practable/refrigeration/documentation/Gunt ET411C Refrigeration experiment conversion parts list.xlsx

Sheet: Mechanical parts
Part required | Manufacturer | Mfr P.N. | Price | Supplier | Qty Rq'd |  | Total | Delivery time | Link
solenoid valve body | Danfoss | 032f8107 | £30.68 | Dean&Wood | 8 |  | £245.44 | 1-2 days | https://www.dean-wood.co.uk/all-products/mechanical-controls/solenoid-valves-coils/danfoss-solenoid-valves/032f805600/danfoss-solenoid-valves-evr-flare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
solenoid valve coil | Danfoss | 018F6857 | £48.63 | Dean&Wood | 8 |  | £389.04 | 1-2 days | https://www.dean-wood.co.uk/all-products/mechanical-controls/solenoid-valves-coils/danfoss-solenoid-coils/018f685600/danfoss-solenoid-coils-12-24v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
30bar pressure sensor | Alco | PT3 30V 802 281 |  | Radwood | 1 |  | £185.17 | 9-11 weeks | https://www.radward.co.uk/alco/pt3-30v-802281 | https://apjeuropean.co.uk/contact/
 |  |  |  | Dean&Wood |  |  | £272.22 | 4-6weeks | USE THIS ONE - DUE TO LEAD TIME
18L flow meter | ABB | FAM3255 |  | JWF Ltd | 1 |  | £1623.11 | 8-9 weeks | https://library.e.abb.com/public/8e1f9d214ac8421ca3b166d2a52b90ee/DS_FAM3200_EN_G.pdf
Degas-regas (2 visits) | Swan Refrigeration |  | £300.00 |  | 1 |  | £300.00 |  | 0131 448 0880 ask for George
Terminals/wires etc | misc |  | £150.00 |  | 1 |  | £150.00
 |  |  |  |  |  |  | Grand total
 |  |  |  |  |  |  | £2979.81
 |  |  |  |  |  | Plus 20% | £3575.77

Sheet: Electronic parts
 |  |  |  |  | V |  |  |  |  |  | W | W | A
 | Equipment |  | Quantity |  | Vin | Signal | Link |  | Cost€ | Cost (£) | Power (single) | Power Total | I @ 24v
Digital Outputs
 |  |  |  |  |  |  | ADAM-5069
 | Valve Relay |  | 8 |  | 24v coil | n/a | https://buy.advantech.eu/I-O-Devices-Communication/Remote-I-O-Modules-ADAM-I-O-Modules/model-ADAM-5069-AE.htm |  | €128.64 |  | 16 | 128 | 5.33
 |  |  |  |  |  |  | 8 ch relay output module
Analog Inputs
 | Pressure Sensors (1-6V) |  | 3 |  | 10-28 | 1-6v | ADAM-5017 |  |  |  | 5 | 15 | 0.62
 |  |  |  |  |  |  | https://buy.advantech.eu/I-O-Devices-Communication/Remote-I-O-Modules-ADAM-I-O-Modules/model-ADAM-5017-A4E.htm |  | €236.54
 | Temperature Sensor (TC) |  | 5 |  | already in system | 0-10 (max) | mV, V, mA input |  |  |  | 5 | 25 | 1.04
 |  |  |  |  |  |  | 8 channel differential
 |  | Total | 8
 |  |  |  |  |  |  | ADAM-5017
 | Flow Meter (4-20mA) |  | 1 |  | 10-28 |  | https://buy.advantech.eu/I-O-Devices-Communication/Remote-I-O-Modules-ADAM-I-O-Modules/model-ADAM-5017-A4E.htm |  | €236.54 |  | 5 | 5 | 0.21
 |  |  |  |  |  |  | mV, V, mA input
 |  |  |  |  |  |  | 8 channel differential
DAQ Chassis
 |  |  |  |  |  |  | ADAM-5000 DAQ Chassis
 | ADAM 4 Slot Ethernet |  | 1 |  | 24v |  | https://buy.advantech.eu/I-O-Devices-Communication/Remote-I-O-Modules-ADAM-Controllers/model-ADAM-5000L/TCP-BE.htm |  | €398.00 |  | 5 | 5 | 0.21
 |  |  |  |  |  |  | https://www.impulse-embedded.co.uk/products/adam_5000l~tcp--Distributed-DAQ-system.htm | alt supplier
Power Supply
 |  |  |  |  |  |  | Weidmuller 24v PSU
 | 24v PSU |  | 1 |  | 240v | 24v | https://uk.rs-online.com/web/p/din-rail-power-supplies/9236504 |  |  | £131.96
Sundrie Electronics Parts (terminals etc) |  |  |  |  |  |  |  |  |  | £200.00
 |  |  |  |  |  |  | Total |  | €999.72 | £331.96 |  | 178 | 7.4
 |  |  |  |  |  |  |  |  | £854.46
 |  |  |  |  |  |  |  | Total Total |  | £1186.42
 |  |  |  | £ | €0.00
 |  |  | Exchange Rate | £1.00 | £1.17 |  |  | plus 20% |  | £1423.71
 |  |  |  | £0.85 | €1.00
