practable/refrigeration/documentation/2. Experiment data 202310.19-2023.10.20.xlsx

Refrigeration experiment Date (2023.10.19-2023.10-20)
 | Ts(min) | T1(°C) | T2(°C) | T3 (°C) | T4(°C) | T5(°C) | p1(bar) | p2(bar) | p3(bar) | F(L/h) | E(W)
Initial (2023.10.19) | 0 | 26.5 | 26.5 | 26.8 | 27.5 | 27.1 | 6 | 6 | 6 | 0 | 0
Expansion Valve(half open) | 30 | 6.7 | 56 | 44.8 | 7.2 | 6.4 | 2.62 | 11.48 | 11.52 | 7.5 | 203.2 | 204.7 | 202.6
Interval for next experiment | 33 | 28.2 | 29.2 | 26.5 | 21.9 | 23.8 | 5 | 7 | 7 | 0 | 0
Capillary X1(half open) | 33 | 13.9 | 82.5 | 38.8 | 5.6 | 5.3 | 2.58 | 12.5 | 12.54 | 6 | 200.2 | 201.5 | 199.9
Initial(2023.10.20) | 0 | 23.6 | 23.6 | 24 | 24 | 24.5 | 5.5 | 5.5 | 5.5 | 0 | 0
Capillary X2 | 31 | 5.4 | 69.5 | 43.4 | 5.4 | 4.9 | 2.45 | 11.49 | 11.52 | 6.9 | 198.4 | 199.7 | 197.5
Interval for next experiment | 30 | 25.6 | 30 | 25.4 | 24 | 25 | 5.3 | 6.8 | 6.8 | 0 | 0
Capillary X3 | 30 | 13.7 | 85.9 | 35.3 | 5.6 | 4.9 | 2.42 | 14.3 | 14.3 | 6.2 | 207.4 | 206.9 | 208.3
Interval for next experiment | 60 | 30.7 | 31.4 | 26.9 | 26.4 | 26.4 | 5.8 | 6.6 | 6.7 | 0 | 0
Expansion Valve(fully open) | 33 | 7 | 68.6 | 46.4 | 7.5 | 6.9 | 2.65 | 11.1 | 11.3 | 7.5 | 208.3 | 209.1 | 208.6
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
