practable/refrigeration/documentation/refrigeration-experiment-P&ID.jpg

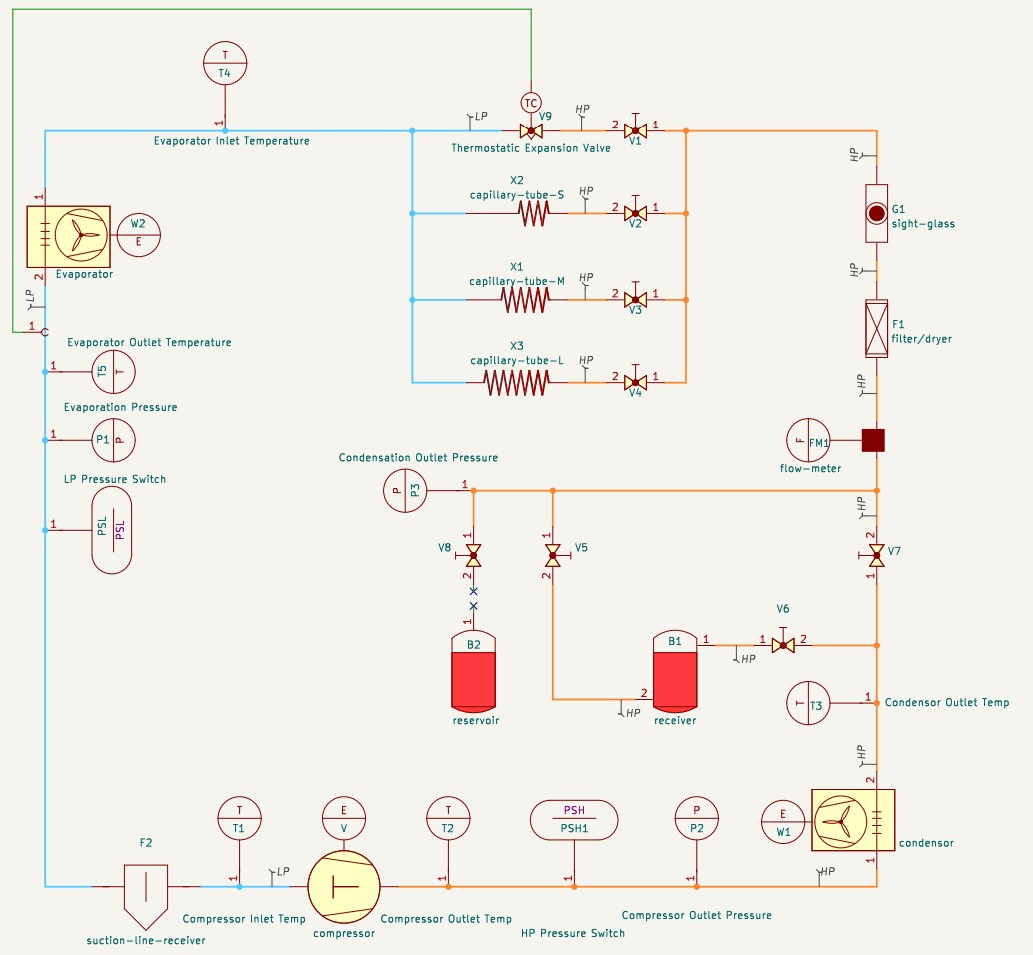
documentation/refrigeration-experiment-P&ID.jpg
