practable/refrigeration/documentation/BME280_breakout_schematic.pdf

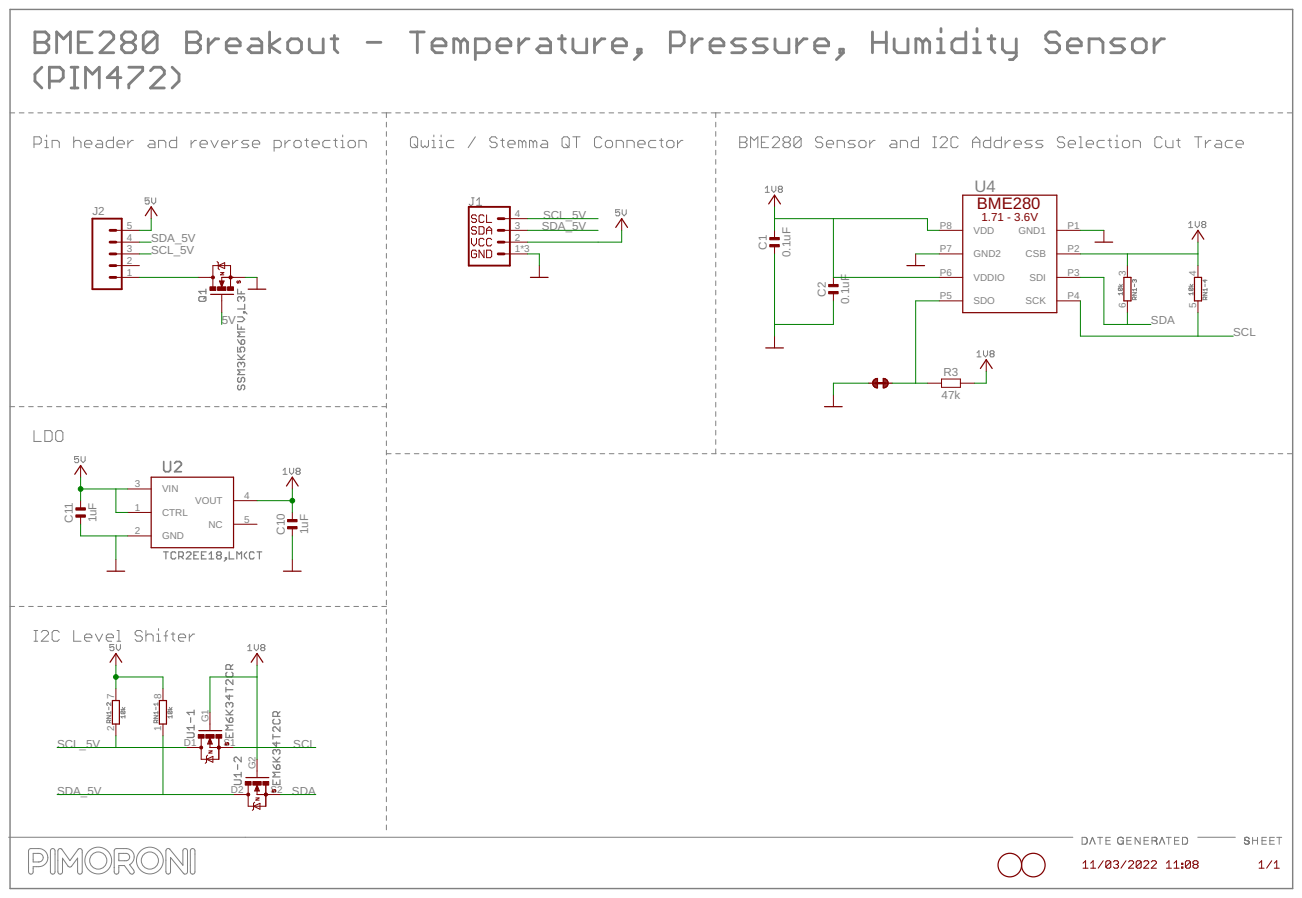
[picture p5: page 1]
