practable/refrigeration/refridgeration-rig-P&ID/refridgeration-rig-P&ID.kicad_sch

## KiCad design refridgeration-rig-P&ID/refridgeration-rig-P&ID.kicad_sch (2024-02-01)

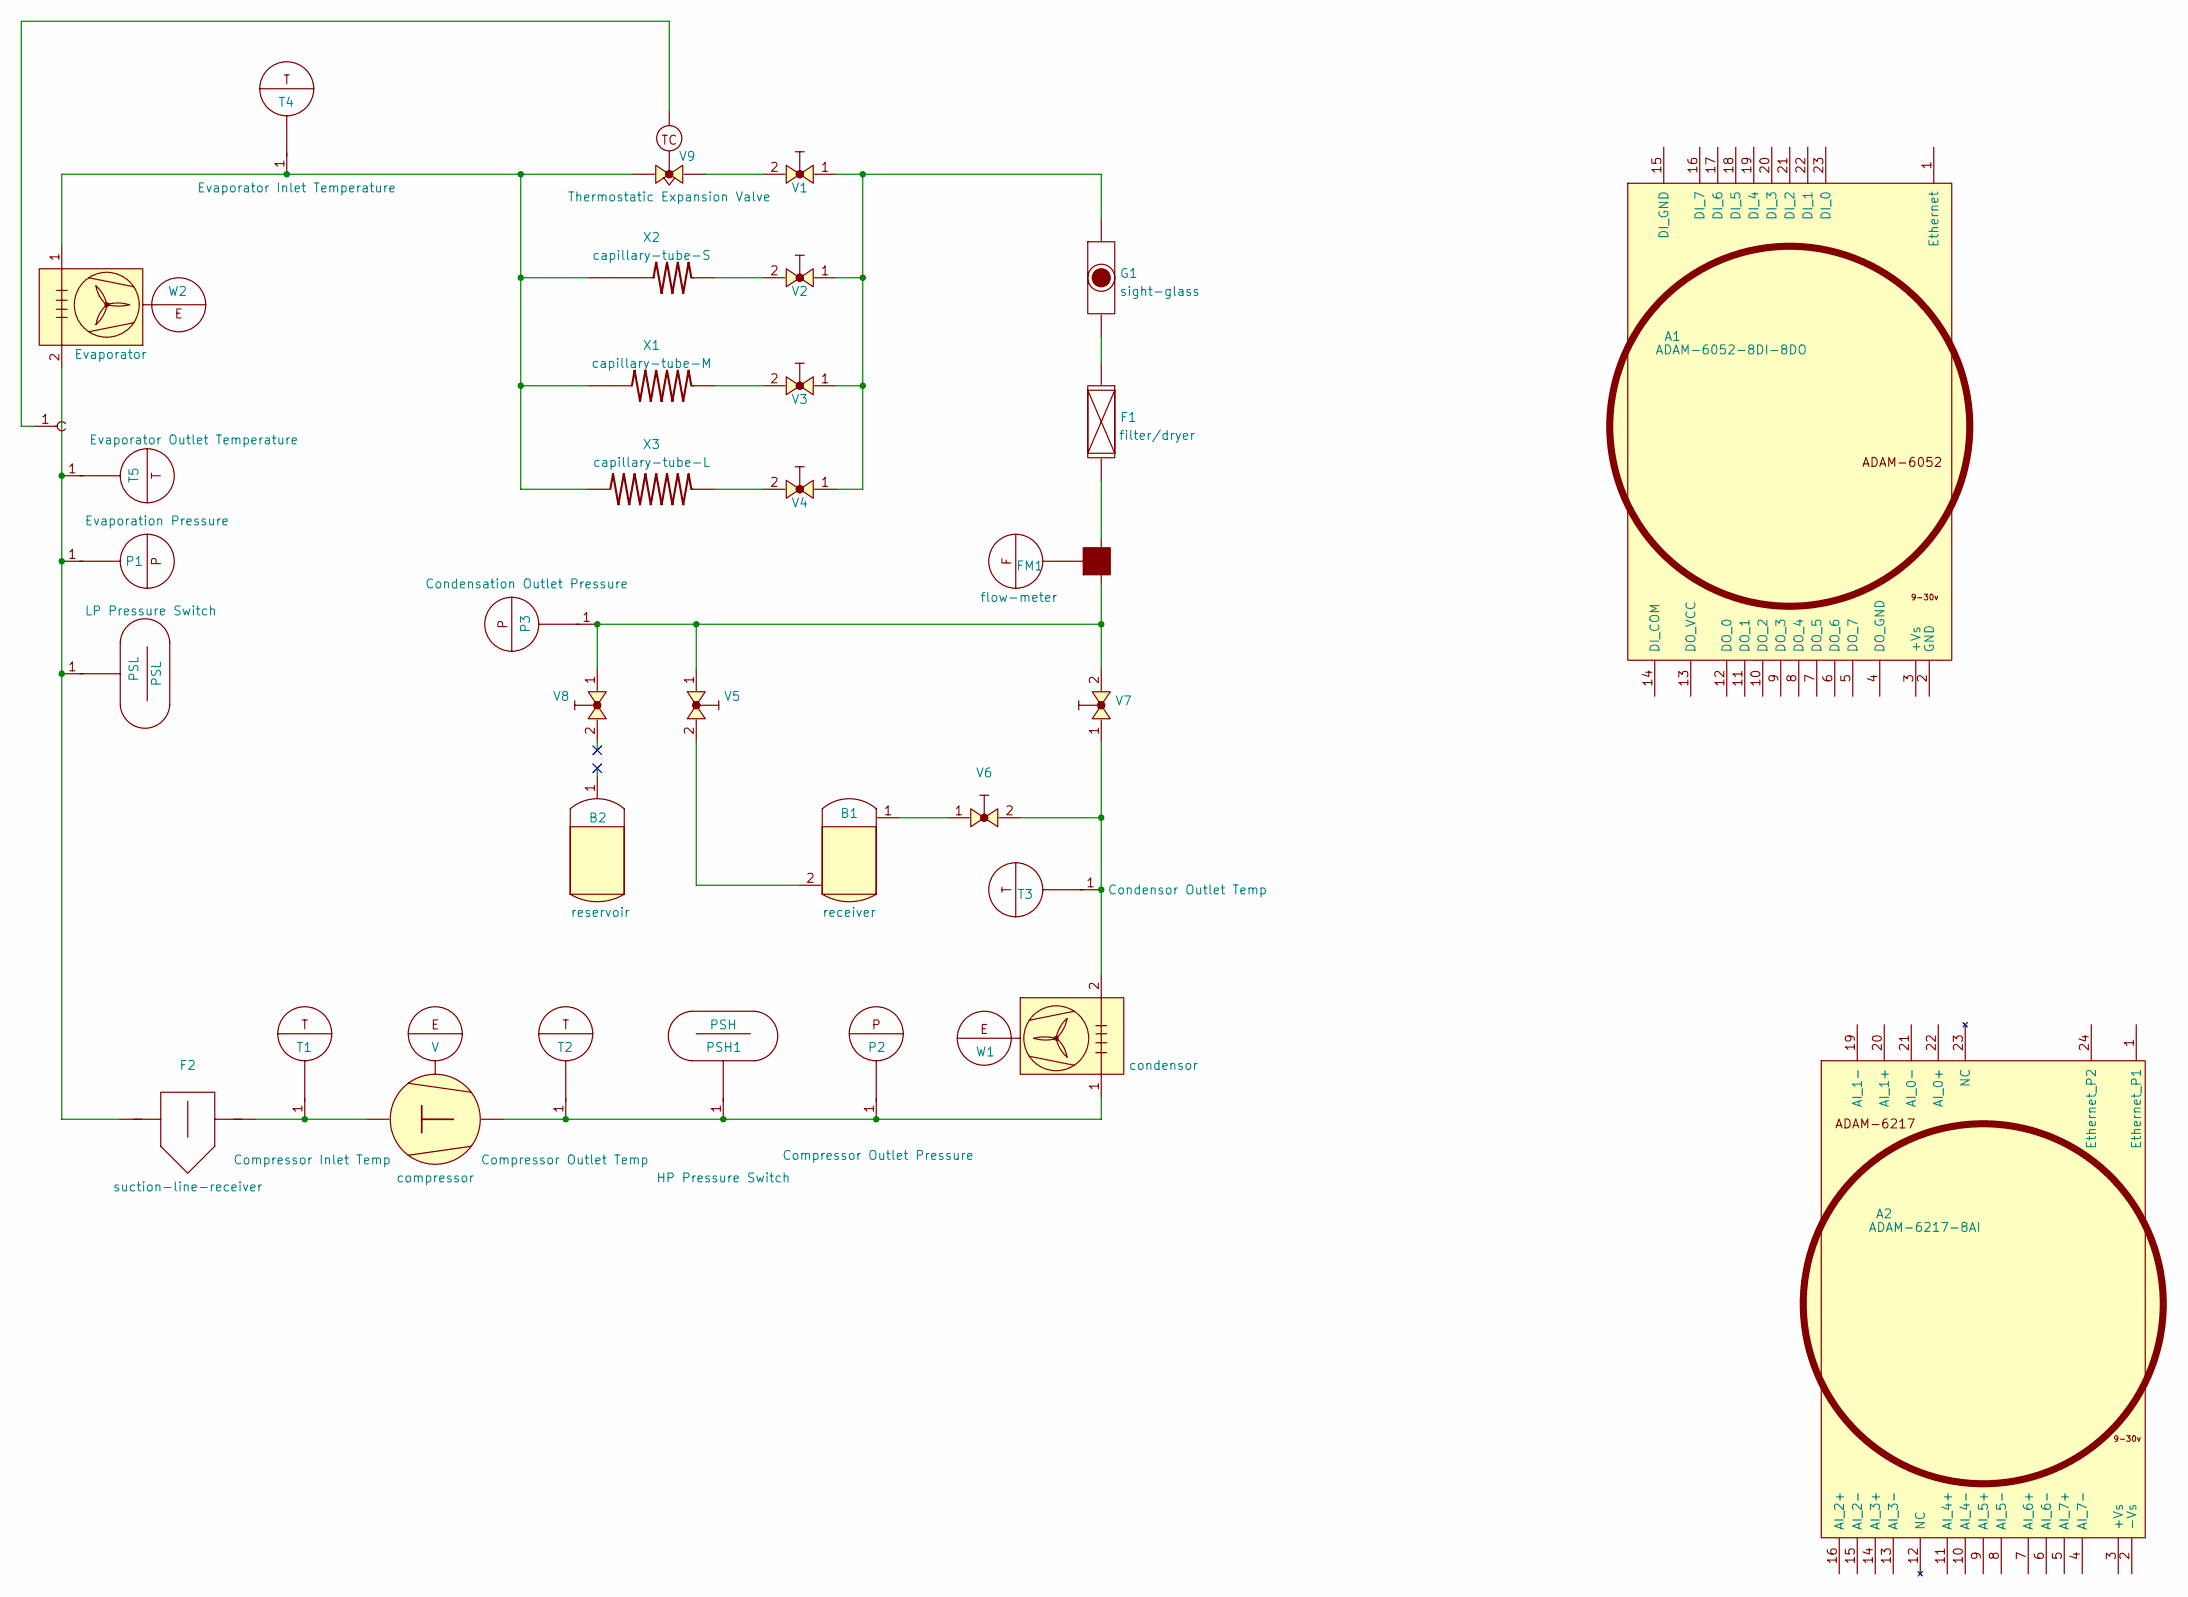
[picture p6: schematic refridgeration-rig-P&ID.kicad_sch]

Parts:
A1: ADAM-6052-8DI-8DO
A2: ADAM-6217-8AI
B1: receiver
B2: reservoir
F1: filter/dryer
F2: suction-line-receiver
FM1: flow-meter
G1: sight-glass
P1: Evaporation Pressure
P2: Compressor Outlet Pressure
P3: Condensation Outlet Pressure
PSH1: HP Pressure Switch
PSL: LP Pressure Switch
S1: sense-bulb
T1: Compressor Inlet Temp
T2: Compressor Outlet Temp
T3: Condensor Outlet Temp
T4: Evaporator Inlet Temperature
T5: Evaporator Outlet Temperature
V: compressor
V1, V2, V3, V4, V5, V6, V7, V8: valve-manual
V9: Thermostatic Expansion Valve
W1: condensor
W2: Evaporator
X1: capillary-tube-M
X2: capillary-tube-S
X3: capillary-tube-L

Connections:
unnamed: B1.1 (in), V6.1 (in)
unnamed: B1.2 (out), V5.2 (out)
unnamed: F1.1 (in), FM1.2 (out)
unnamed: F1.2 (out), G1.1 (in)
unnamed: F2.1 (in), P1.1, PSL.1, T5.1, W2.2 (out)
unnamed: F2.2 (out), T1.1, V.1 (in)
unnamed: FM1.1 (in), P3.1, V5.1 (in), V7.2 (out), V8.1 (in)
unnamed: G1.2 (out), V1.1 (in), V2.1 (in), V3.1 (in), V4.1 (in)
unnamed: P2.1, PSH1.1, T2.1, V.2 (out), W1.1 (in)
unnamed: S1.1, V9.3 (ctrl)
unnamed: T3.1, V6.2 (out), V7.1 (in), W1.2 (out)
unnamed: T4.1, V9.1 (in), W2.1 (in), X1.1 (in), X2.1 (in), X3.1 (in)
unnamed: V1.2 (out), V9.2 (out)
unnamed: V2.2 (out), X2.2 (out)
unnamed: V3.2 (out), X1.2 (out)
unnamed: V4.2 (out), X3.2 (out)
