practable/refrigeration/fw/depreciated-versions/refrigerationFirmware_V1_3_2/adamController.h

#include <string.h>
/*   adamController.h

  arduino/c++ library for control of generic Advantech Data Aquisition Modules (ADAM-xxxx) 

  Imogen Heard
    21/12/23


*/

#pragma once

#ifndef adamController_h
#define adamController_h

#include <Ethernet.h>
#include <ArduinoRS485.h>  // ArduinoModbus depends on the ArduinoRS485 library
#include <ArduinoModbus.h>

#if (ARDUINO >= 100)
#include "Arduino.h"
#else
#include "WProgram.h"
#endif



// define type for analog inputs/output (this changes the format of the data returned from analog inputs,[ DAC value (0-65525), voltage, current]
#define DAC_OUTPUT 0
#define VOLTAGE_OUTPUT 1
#define CURRENT_OUTPUT 2

class adamController {


private:



  EthernetClient ethClient;
  IPAddress serverIP;
  ModbusTCPClient modbusTCP;

public:

  // Constructor

  adamController(EthernetClient _client, IPAddress _server, int _analogType = 0, const char _moduleID[32] = { "ADAM-xxxx" })
    : ethClient(_client),
      serverIP(_server),
      modbusTCP(ethClient),
      analogType(_analogType) {
    strcpy(moduleName, _moduleID);
  }

  // Constants

  const int d_out[8] = { 0x10, 0x11, 0x12, 0x13, 0x14, 0x15, 0x16, 0x17 };
  const int d_in[8] = { 0x00, 0x01, 0x02, 0x03, 0x04, 0x05, 0x06, 0x07 };
  const int a_out[8] = {};
  const int a_in[8] = { 0x00, 0x01, 0x02, 0x03, 0x04, 0x05, 0x06, 0x07 };

  struct dataArray {
    uint16_t i_data[8];        // Always holds the direct ADC value read from data aquisition module
    float f_data[8];           // holds the calculated voltage or current value, or a copy of the ADC as a float
    uint32_t timeStamp_mS[8];  // holds the time data was sampled in mS from time of power up
  } d_array;

  // Methods

  void begin();

  void check_modbus_connect();

  int16_t set_coil(int coilNum, bool coilState = false);
  int16_t set_coils(uint8_t coilStates = 0b00000000);
  int16_t read_coil(uint8_t outputNum);
  int16_t read_coils();


  int16_t read_digital_input(uint8_t inputNum);
  int16_t read_digital_inputs();

  int16_t read_analog_input(uint8_t inputNum);
  dataArray read_analog_inputs();

  float adc_to_voltage(uint16_t _adcvalue);
  float adc_to_current(uint16_t _acdvalue);

  void printBin(int16_t binaryVal);

  // Variables
  char moduleName[32] = { "ADAM-xxxxA" };
  bool modbusConnected = false;

  int16_t g_coilState = 0b00000000;
  int16_t g_inputState = 0b00000000;

  uint8_t bitmask[8] = {
    0b00000001,
    0b00000010,
    0b00000100,
    0b00001000,
    0b00010000,
    0b00100000,
    0b01000000,
    0b10000000
  };



private:
  int analogType = 0;
  char leadingZeros[9][9] = { "", "0", "00", "000", "0000", "00000", "000000", "0000000", "00000000" };
};


#endif
