practable/refrigeration/(commit log)

2023-12-14 added arduino statemachine
2023-12-15 added arduino firmware
2023-12-19 adam controller arduino updates
2023-12-21 work on sensor object library
2023-12-21 arduino is FUNCTIONAL (no sensor reporting) all digital IO integrated to state machine
2024-01-03 RANDOM BUFFER OVERFLOW ISSUE WHY?
    [adamController.cpp, adamController.h, globals.h, sensorObj.cpp, sensorObj.h, stateMachine.h]
2024-01-04 working on JSON sensor reporting function buffer issue solved
    [adamController.cpp, globals.h, stateMachine.h]
2024-01-04 maybe almost "complete" sensor sampling bit of a mess still
2024-01-05 updated generic sensors algorithm. added pressure sensor function
2024-01-08 Updated sensorObj library
2024-01-31 Fixed sensor values - firmware now functional
    [adamController.cpp, sensorObj.cpp, sensorObj.h, stateMachine.h]
2024-02-01 added P&ID files & documentation from old project folders
    [2. Experiment data 202310.19-2023.10.20.xlsx, Gunt ET411C Refrigeration experiment conversion parts list.xlsx, refridgeration-rig-P&ID.kicad_pcb, refridgeration-rig-P&ID.kicad_sch]
2024-02-13 added datasheet for BME/P 280 atmospheric sensor
2024-02-13 Finished adding i2c sensor - UNTESTED
2024-02-13 Firmware still in testing, issue with debug print of BME280 causing crash
    [globals.h]
2024-02-14 Finished Version 1.1.0 - needs testing on equipment before merging
    4. Version 1.1.0: 14/02/24
    - Added i2c sensor for Atmospheric temp, pressure & humidity
    - Improved debugging and unit disabling options
    - Devolved functions from .ino to organised tabs
    - Increased JSON buffer size to 720 bytes
    ```
    Sketch uses 49912 bytes (19%) of program storage space. Maximum is 253952 bytes.
    Global variables use 6613 bytes (80%) of dynamic memory, leaving 1579 bytes for local variables. Maximum is 8192 bytes.
    ```
2024-02-15 testing firmware - small changes bus flow and power sensors broken
    [adamController.cpp, adamController.h, globals.h, sensorFunctions.h]
2024-02-15 workimng through sensor wrong value bugs
    [ArduinoJson-v6.9.1.h, adamController.cpp, adamController.h, adamFunctions.h, globals.h, jsonFunctions.h, otherFunctions.h, sensorFunctions.h]
2024-02-15 changed sensorObject calibration functions & updated sensor calibration
2024-03-20 updated firmware to V1.2.1. JSONised all serial prints.
2024-03-28 finished V1.3.1 & tested with hardware
    Version 1.3.1: 28/04/2024
    - Removed additional commas from JSON message - BUG FIX
    - Changed double to single quotes to wrap JSON
    - rebooting error detected - stackoverflow?
    - Reduced size of JSON buffer from 720 to 620
    - Fixed rebooting error but check for problem reappearing
    - #TODO: If rebooting issue or stackoverflow reappears devolve pretty print JSON into own function & only load into memory if option is selected
    Sketch uses 50780 bytes (19%) of program storage space. Maximum is 253952 bytes.
    Global variables use 6921 bytes (84%) of dynamic memory, leaving 1271 bytes for local variables. Maximum is 8192 bytes.
    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
    [ArduinoJson-v6.9.1.h, adamController.cpp, adamController.h, adamFunctions.h, globals.h, jsonFunctions.h, otherFunctions.h, sensorFunctions.h]
2024-03-28 changed version printout to reflect new firmware version
2024-03-28 removed defunct function, changed JSON print to use \n instead of println
2024-04-15 started work on v 1.4.0 to include warnings for high/low pressure
2024-11-11 added timer for new lighting function
2024-11-12 updated with lights control, timer for lights and 1h timeout for experiment
